adrienbrault/cmp-170hx-duct/releases/fractal-fit-gauge/fractal-plug-fit-gauge-top.png

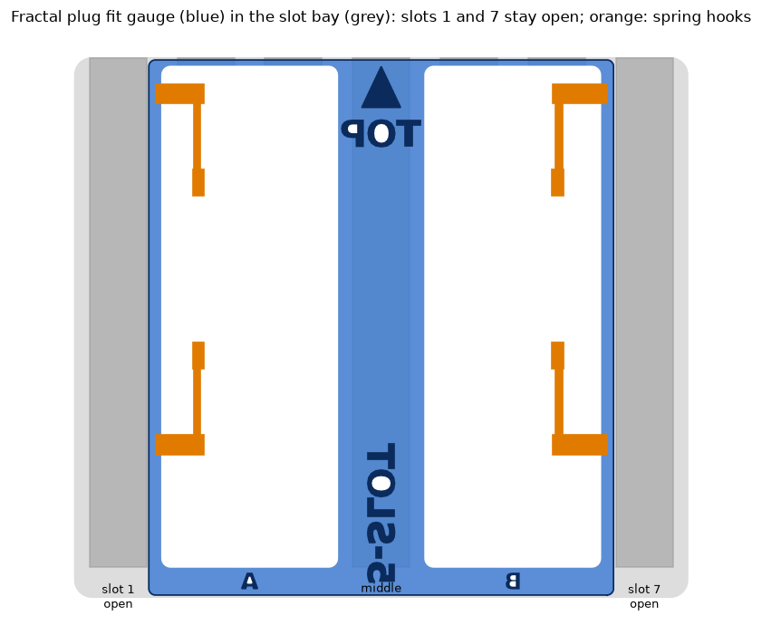
releases/fractal-fit-gauge/fractal-plug-fit-gauge-top.png
