adrienbrault/cmp-170hx-duct/(list of files, cad)

Other CAD files:
releases/a29/dual-170hx-a29-fit-check.stl
releases/a30/dual-170hx-continuous-a30.stl
releases/a31/dual-170hx-a31-fit-check.stl
releases/collector-v3/dual-170hx-collector-v3-fit-gauge.stl
releases/collector-v4-4slot/dual-170hx-collector-v4-4slot-fit-gauge.stl
releases/collector-v4-5slot/dual-170hx-collector-v4-5slot.stl
releases/fractal-fit-gauge/fractal-plug-fit-gauge.stl
releases/v31/dual-170hx-continuous-v31.stl
releases/a29/dual-170hx-continuous-a29.stl
releases/a30/dual-170hx-a30-fit-check.stl
releases/a31/dual-170hx-continuous-a31.stl
releases/collector-v3/dual-170hx-collector-v3.stl
releases/collector-v4-4slot/dual-170hx-collector-v4-4slot.stl
releases/collector-v4-5slot/dual-170hx-collector-v4-5slot-fit-gauge.stl
releases/v31/dual-170hx-v31-fit-check.stl
releases/collector-v1/dual-170hx-collector-v1-fit-gauge.stl
releases/collector-v2/dual-170hx-collector-v2-fit-gauge.stl
releases/v23/dual-170hx-v23-fit-check.stl
releases/collector-v1/dual-170hx-collector-v1.stl
releases/collector-v2/dual-170hx-collector-v2.stl
releases/v23/dual-170hx-continuous-v23.stl
releases/v24/dual-170hx-continuous-v24.stl
releases/v24/dual-170hx-v24-fit-check.stl
releases/v25/dual-170hx-continuous-v25.stl
releases/v25/dual-170hx-v25-fit-check.stl
releases/v27/dual-170hx-continuous-v27.stl
releases/v27/dual-170hx-v27-fit-check.stl
releases/v28/dual-170hx-continuous-v28.stl
releases/v29/dual-170hx-continuous-v29.stl
releases/v29/dual-170hx-v29-fit-check.stl
releases/v30/dual-170hx-continuous-v30.stl
releases/v30/dual-170hx-v30-fit-check.stl
