adrienbrault/cmp-170hx-duct/(commit log)

2026-10-20 Dual CMP 170HX fan duct
    Parametric, printability-gated 3D-printable ducting for two passively
    cooled NVIDIA CMP 170HX cards: the V30/A30 push ducts, exhaust
    collectors, the duct CLI (CAD, print gates, OpenFOAM CFD, previews).
2026-11-07 V31/A31: 2.4 mm collars and the latch-notch wall 1 mm closer to the plug
    The printed A30's collar broke along the layer line where the 1.2 mm skin
    bends into it. collar_reinforce thickens each collar outward (bore, fit and
    air passage unchanged) with a 34 deg foot that fills the bend, clipped to
    the shell's outline grown at the same angle so it prints without support.
    The latch notch's far wall left ~1 mm of the card's fin tunnel open beside
    the lever, which leaked. The notch is now 1.2 mm past the housing
    clearance; the resting lever pad keeps 0.3 mm over its envelope, but the
    hook can no longer swing open with the duct on.
2026-11-07 releases/a31, releases/v31: gated releases, previews with the A30/V30 fields
    A31: 156 min / 74.8 g, V31: 172 min / 82.7 g on P1S / 0.28 mm PETG, no
    supports, zero plug/latch collision; open card face per seat 21.5 -> 14.3
    mm2. README points at V31/A31.
